WarriorOfWire/Voron-2/mods/warriorofwire/bmg_direct_drive/gumby_mount_v6.stl

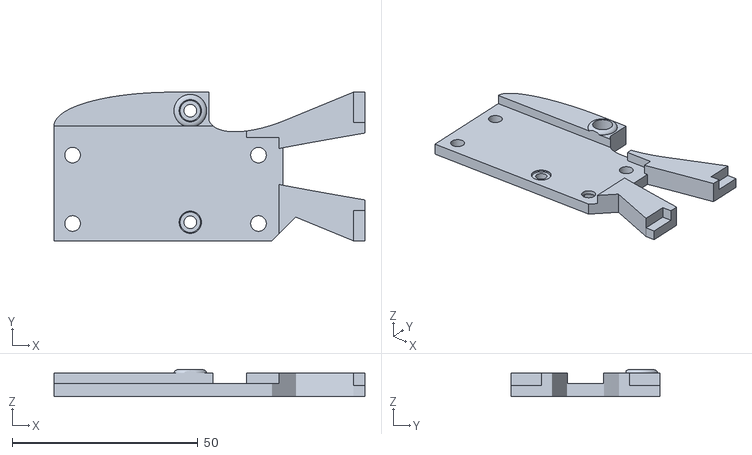
[picture p1: CAD file, 2019-11-05]
mods/warriorofwire/bmg_direct_drive/gumby_mount_v6.stl
83.6 x 40.0 x 7.32
