WarriorOfWire/Voron-2/mods/warriorofwire/bmg_direct_drive/steps/gumby_mount_mosquito.step

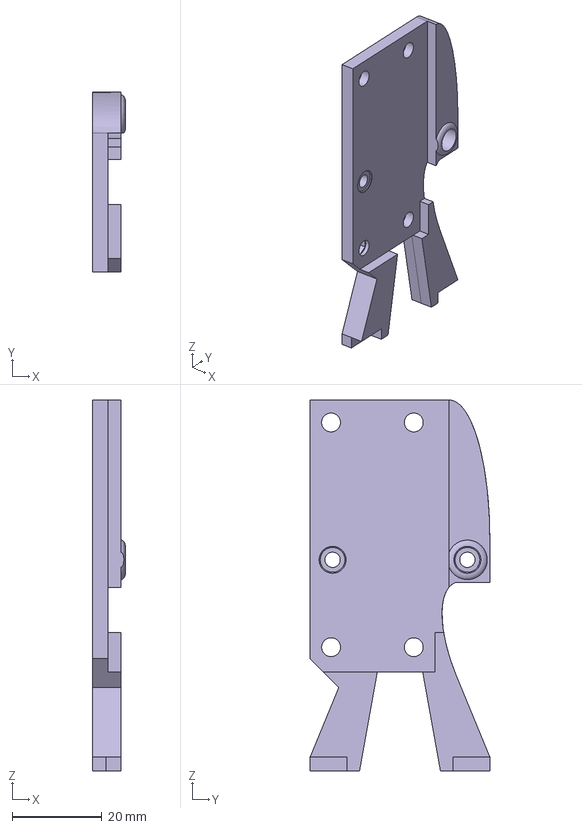
[picture p2: CAD file, 2019-11-05]
mods/warriorofwire/bmg_direct_drive/steps/gumby_mount_mosquito.step
7.32 x 40.0 x 82.5 mm
