WarriorOfWire/Voron-2/mods/warriorofwire/bmg_direct_drive/steps/fan_mount.step

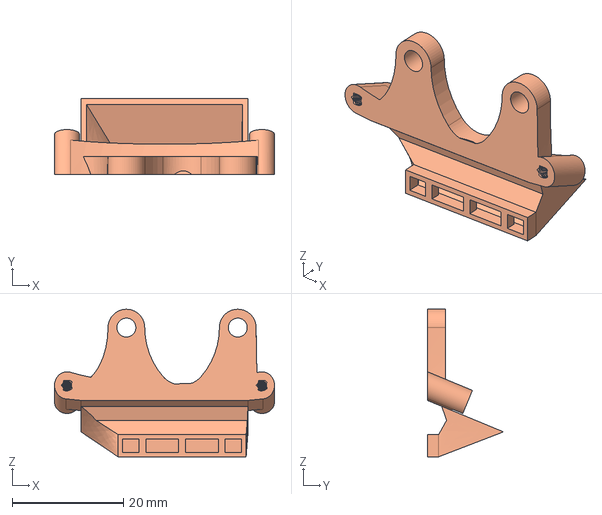
[picture p3: CAD file, 2019-11-05]
mods/warriorofwire/bmg_direct_drive/steps/fan_mount.step
39.5 x 13.6 x 26.5 mm
