WarriorOfWire/Voron-2/(list of files, cad)

Other CAD files:
mods/warriorofwire/bmg_direct_drive/fan_mount.stl
mods/warriorofwire/bmg_direct_drive/gumby_mount_mosquito.stl
